Academic-Laboratory-Group/KL05_tester/README.md

# KL05_tester
Project for studies on subject Testing and Reliability.  
[Movie on YouTube](https://youtu.be/P3iQw-8CX4w)
