Academic-Laboratory-Group/KL05_tester/KiCadFiles/TestBed_KL05_variant_01_f.kicad_pcb

## KiCad design KiCadFiles/TestBed_KL05_variant_01_f.kicad_pcb (2021-08-31)

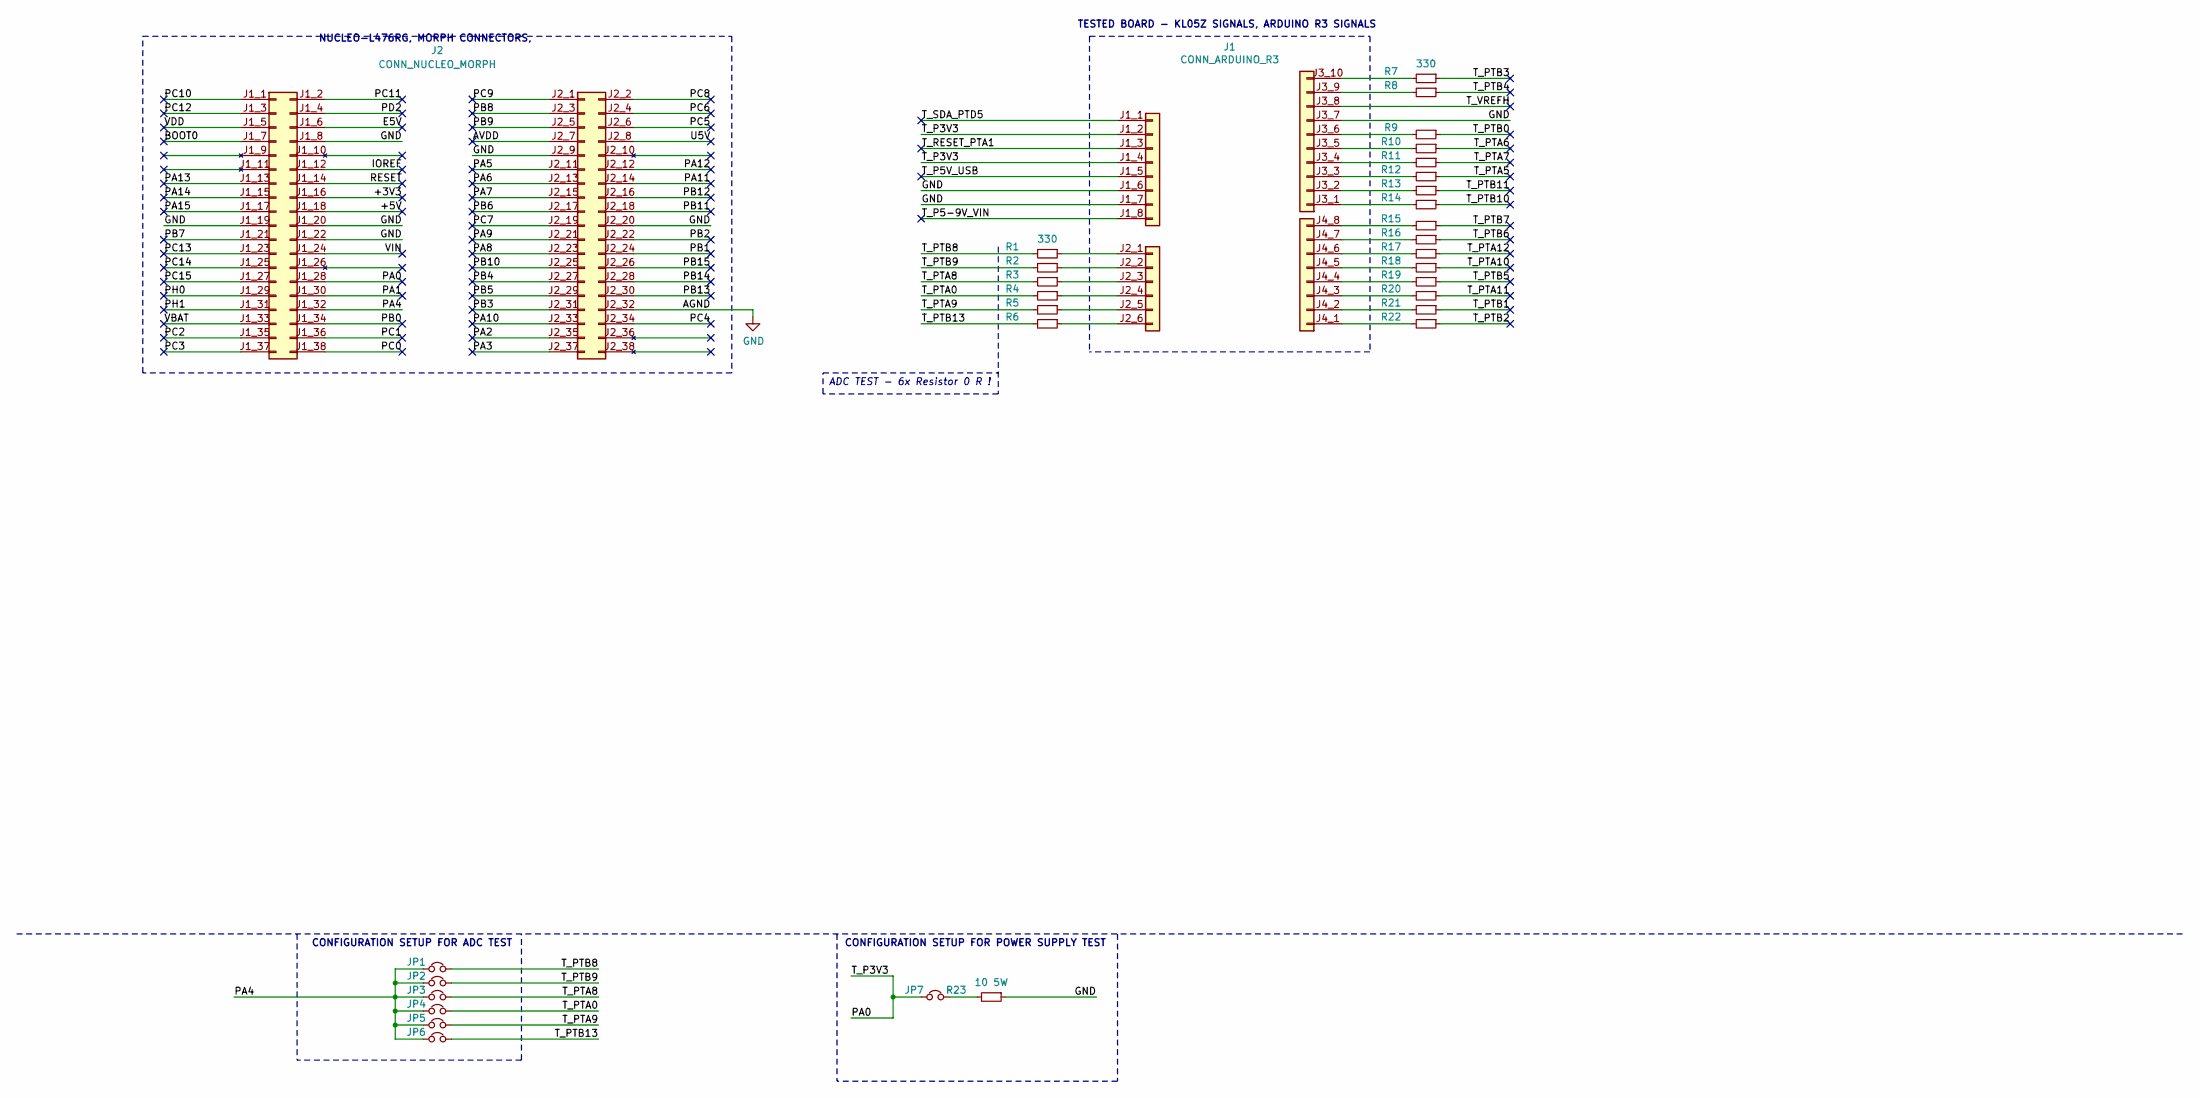
[picture p48: schematic TestBed_KL05_variant_01_f.sch]

Parts:
J1: CONN_ARDUINO_R3
J2: CONN_NUCLEO_MORPH; CONN_MORPH_NUCLEO
JP1, JP2, JP3, JP4, JP5, JP6, JP7: Jumper; PinHeader_1x02_P2.54mm_Vertical
R1, R2, R3, R4, R5, R6, R7, R8, R9, R10, R11, R12, R13, R14, R15, R16, R17, R18, R19, R20, R21, R22: 330; R_0805_2012Metric_Pad1.15x1.40mm_HandSolder
R23: 10 5W; R_Axial_DIN0411_L9.9mm_D3.6mm_P12.70mm_Horizontal

Connections:
/+3V3: J2.J1_16
/+5V: J2.J1_18
/AVDD: J2.J2_7
/BOOT0: J2.J1_7
/E5V: J2.J1_6
/IOREF: J2.J1_12
/PA0: J1.J1_2, J1.J1_4, J2.J1_28, JP7.2
/PA1: J2.J1_30
/PA2: J2.J2_35
/PA3: J2.J2_37
/PA4: J2.J1_32, JP1.2, JP2.2, JP3.2, JP4.2, JP5.2, JP6.2
/PA5: J2.J2_11
/PA6: J2.J2_13
/PA7: J2.J2_15
/PA8: J2.J2_23
/PA9: J2.J2_21
/PA10: J2.J2_33
/PA11: J2.J2_14
/PA12: J2.J2_12
/PA13: J2.J1_13
/PA14: J2.J1_15
/PA15: J2.J1_17
/PB0: J2.J1_34
/PB1: J2.J2_24
/PB2: J2.J2_22
/PB3: J2.J2_31
/PB4: J2.J2_27
/PB5: J2.J2_29
/PB6: J2.J2_17
/PB7: J2.J1_21
/PB8: J2.J2_3
/PB9: J2.J2_5
/PB10: J2.J2_25
/PB11: J2.J2_18
/PB12: J2.J2_16
/PB13: J2.J2_30
/PB14: J2.J2_28
/PB15: J2.J2_26
/PC0: J2.J1_38
/PC1: J2.J1_36
/PC2: J2.J1_35
/PC3: J2.J1_37
/PC4: J2.J2_34
/PC5: J2.J2_6
/PC6: J2.J2_4
/PC7: J2.J2_19
/PC8: J2.J2_2
/PC9: J2.J2_1
/PC10: J2.J1_1
/PC11: J2.J1_2
/PC12: J2.J1_3
/PC13: J2.J1_23
/PC14: J2.J1_25
/PC15: J2.J1_27
/PD2: J2.J1_4
/PH0: J2.J1_29
/PH1: J2.J1_31
/RESET: J2.J1_14
/T_P5-9V_VIN: J1.J1_8
/T_P5V_USB: J1.J1_5
/T_PTA0: JP4.1, R4.2
/T_PTA5: R12.1
/T_PTA6: R10.1
/T_PTA7: R11.1
/T_PTA8: JP3.1, R3.2
/T_PTA9: JP5.1, R5.2
/T_PTA10: R18.1
/T_PTA11: R20.1
/T_PTA12: R17.1
/T_PTB0: R9.1
/T_PTB1: R21.1
/T_PTB2: R22.1
/T_PTB3: R7.1
/T_PTB4: R8.1
/T_PTB5: R19.1
/T_PTB6: R16.1
/T_PTB7: R15.1
/T_PTB8: JP1.1, R1.2
/T_PTB9: JP2.1, R2.2
/T_PTB10: R14.1
/T_PTB11: R13.1
/T_PTB13: JP6.1, R6.2
/T_RESET_PTA1: J1.J1_3
/T_SDA_PTD5: J1.J1_1
/T_VREFH: J1.J3_8
/U5V: J2.J2_8
/VBAT: J2.J1_33
/VDD: J2.J1_5
/VIN: J2.J1_24
GND: J1.J1_6, J1.J1_7, J1.J3_7, J2.J1_8, J2.J1_19, J2.J1_20, J2.J1_22, J2.J2_9, J2.J2_20, J2.J2_32, R23.1
unnamed: J1.J2_1, R1.1
unnamed: J1.J2_2, R2.1
unnamed: J1.J2_3, R3.1
unnamed: J1.J2_4, R4.1
unnamed: J1.J2_5, R5.1
unnamed: J1.J2_6, R6.1
unnamed: J1.J3_1, R14.2
unnamed: J1.J3_2, R13.2
unnamed: J1.J3_3, R12.2
unnamed: J1.J3_4, R11.2
unnamed: J1.J3_5, R10.2
unnamed: J1.J3_6, R9.2
unnamed: J1.J3_9, R8.2
unnamed: J1.J3_10, R7.2
unnamed: J1.J4_1, R22.2
unnamed: J1.J4_2, R21.2
unnamed: J1.J4_3, R20.2
unnamed: J1.J4_4, R19.2
unnamed: J1.J4_5, R18.2
unnamed: J1.J4_6, R17.2
unnamed: J1.J4_7, R16.2
unnamed: J1.J4_8, R15.2
unnamed: JP7.1, R23.2

Notes on the sheet:
CONFIGURATION SETUP FOR ADC TEST
NUCLEO-L476RG, MORPH CONNECTORS,
ADC TEST - 6x Resistor 0 R !
TESTED BOARD - KL05Z SIGNALS, ARDUINO R3 SIGNALS
CONFIGURATION SETUP FOR POWER SUPPLY TEST

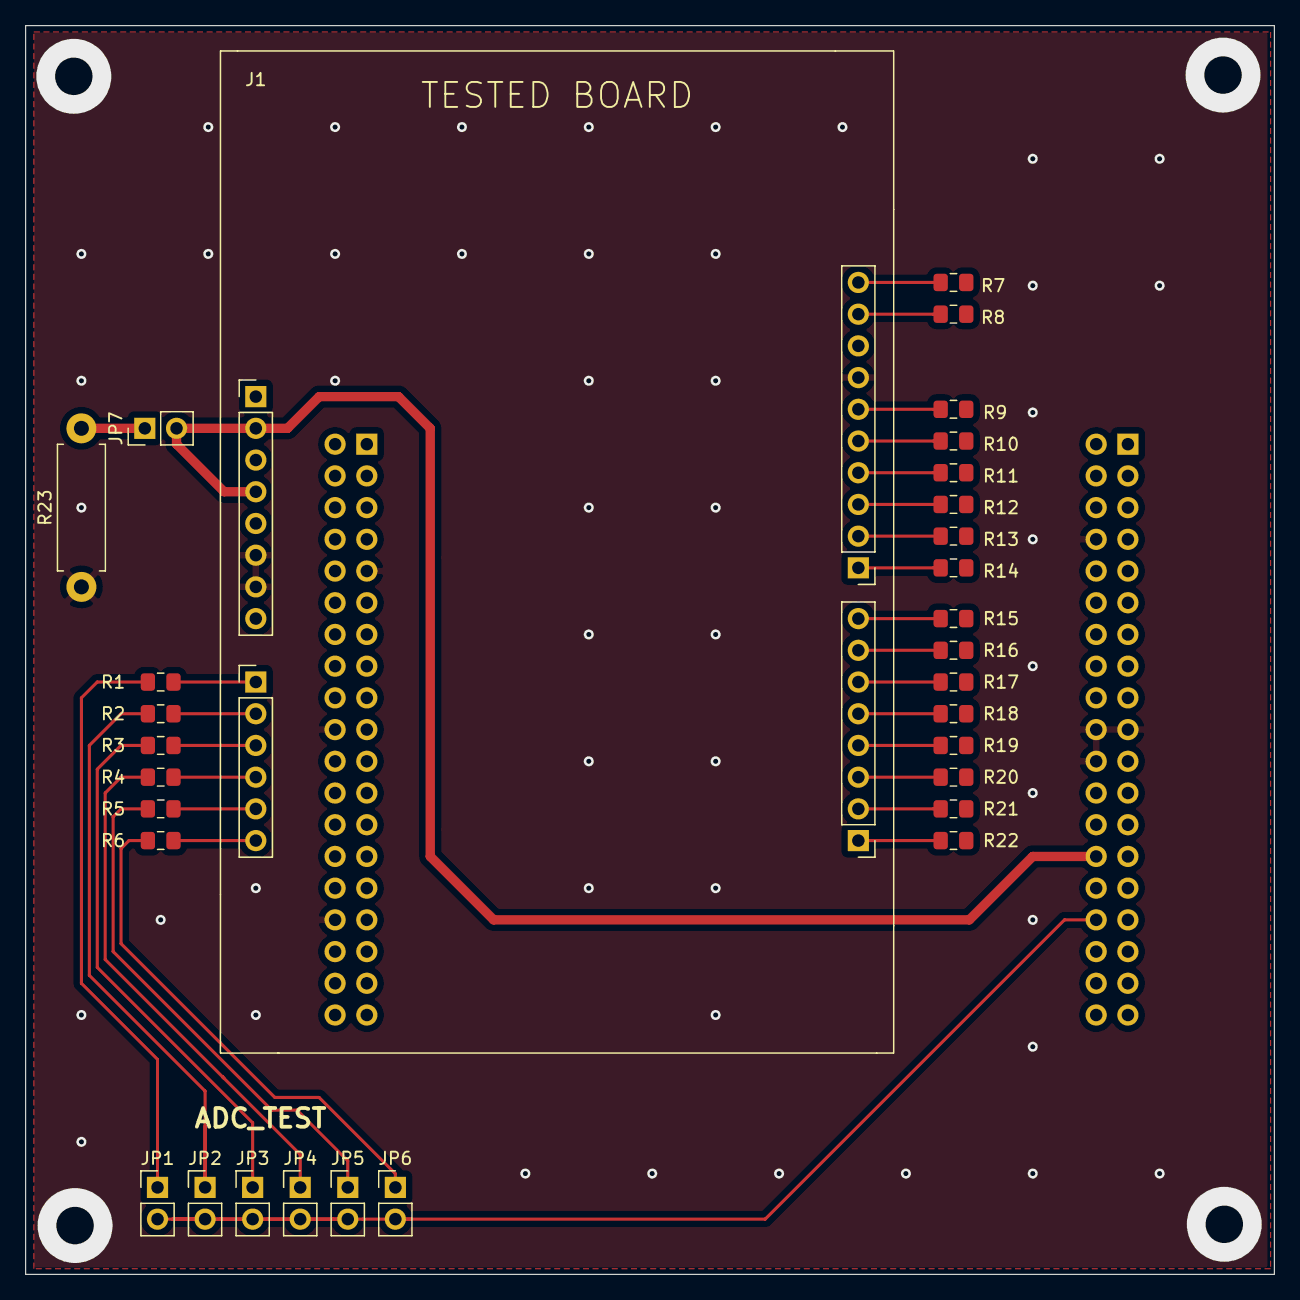
[picture p49: board TestBed_KL05_variant_01_f.kicad_pcb from above]

Board: 2 copper layers, 100.0 x 100.0 mm, 32 parts (1 on the bottom side), 32 nets.
