Academic-Laboratory-Group/KL05_tester/NucleoProjectFiles/ADC/Core/Src/main.c

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
/* Includes ------------------------------------------------------------------*/
#include "main.h"


DAC_HandleTypeDef hdac;

UART_HandleTypeDef huart3;
DMA_HandleTypeDef hdma_usart3_rx;

void SystemClock_Config(void);
static void MX_GPIO_Init(void);
static void MX_DMA_Init(void);
static void MX_USART3_UART_Init(void);
static void MX_DAC_Init(void);
/* USER CODE BEGIN 0 */
void prepare_myTxDataUart3(int value);

uint8_t myTxDataUart3[11] = "";
uint8_t myRxDataUart3[11];

int valueToSet = 0;

uint8_t setValue = 0;

/* USER CODE END 0 */

/**
  * @brief  The application entry point.
  * @retval int
  */
int main(void)
{
  /* MCU Configuration--------------------------------------------------------*/

  /* Reset of all peripherals, Initializes the Flash interface and the Systick. */
  HAL_Init();

  /* Configure the system clock */
  SystemClock_Config();

  /* Initialize all configured peripherals */
  MX_GPIO_Init();
  MX_DMA_Init();
  MX_USART3_UART_Init();
  MX_DAC_Init();
  /* USER CODE BEGIN 2 */
  HAL_UART_Receive_DMA(&huart3, myRxDataUart3, 5);

  HAL_DAC_SetValue(&hdac, DAC_CHANNEL_1, DAC_ALIGN_12B_R, 0);
  HAL_DAC_Start(&hdac , DAC_CHANNEL_1) ;
  /* USER CODE END 2 */

  /* Infinite loop */
  /* USER CODE BEGIN WHILE */
  while (1)
  {
    /* USER CODE END WHILE */

    /* USER CODE BEGIN 3 */

	  if (setValue == 1)
	  {
		  HAL_DAC_SetValue(&hdac, DAC_CHANNEL_1, DAC_ALIGN_12B_R, valueToSet);

		  HAL_Delay(1);

		  prepare_myTxDataUart3(valueToSet);
		  HAL_UART_Transmit(&huart3, myTxDataUart3, 6, 10);
		  setValue = 0;
	  }
  }
  /* USER CODE END 3 */
}

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
/* USER CODE BEGIN 4 */
void HAL_UART_RxCpltCallback(UART_HandleTypeDef *huart)
{
  /* Prevent unused argument(s) compilation warning */
  UNUSED(huart);

  /* NOTE : This function should not be modified, when the callback is needed,
            the HAL_UART_RxCpltCallback can be implemented in the user file.
   */
  valueToSet = ((int)myRxDataUart3[0] - 48) * 1000;
  valueToSet += ((int)myRxDataUart3[1] - 48) * 100;
  valueToSet += ((int)myRxDataUart3[2] - 48) * 10;
  valueToSet += ((int)myRxDataUart3[3] - 48);

  setValue = 1;
}

void prepare_myTxDataUart3(int value){
	int num = 1000;
	for (int i = 0; i < 4 ; i++)
	{
		myTxDataUart3[i] = (char)((value / num ) % 10 + 48);
		num /= 10;
	}
	myTxDataUart3[4] = '\r';
	myTxDataUart3[5] = '\n';
}

/* USER CODE END 4 */
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
