Academic-Laboratory-Group/KL05_tester/NucleoProjectFiles/SupplyTest/SupplyTest.ioc

PH0-OSC_IN.Signal=RCC_OSC_IN
Mcu.UserName=STM32F446RETx
PA14.GPIO_Label=TCK
PC13.GPIO_Label=B1 [Blue PushButton]
PA2.GPIO_Label=USART_TX
PA3.Signal=USART2_RX
PB3.GPIO_Label=SWO
PC13.Signal=GPXTI13
PC14-OSC32_IN.Signal=RCC_OSC32_IN
PA0-WKUP.Signal=ADCx_IN0
PA13.Signal=SYS_JTMS-SWDIO
PC15-OSC32_OUT.Signal=RCC_OSC32_OUT
PA1.Signal=ADCx_IN1
PA5.Signal=GPIO_Output
PH1-OSC_OUT.Signal=RCC_OSC_OUT
PA2.Signal=USART2_TX
PA13.GPIO_Label=TMS
PB3.Signal=SYS_JTDO-SWO
PA5.GPIO_Label=LD2 [Green Led]
PA14.Signal=SYS_JTCK-SWCLK
PA3.GPIO_Label=USART_RX
