Academic-Laboratory-Group/KL05_tester/NucleoProjectFiles/SupplyTest/Core/Src/main.c

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
/* Includes ------------------------------------------------------------------*/
#include "main.h"
#include <stdlib.h>
#include <stdio.h>
ADC_HandleTypeDef hadc1;
DMA_HandleTypeDef hdma_adc1;

TIM_HandleTypeDef htim14;

UART_HandleTypeDef huart2;
DMA_HandleTypeDef hdma_usart2_rx;
DMA_HandleTypeDef hdma_usart2_tx;

void SystemClock_Config(void);
static void MX_GPIO_Init(void);
static void MX_DMA_Init(void);
static void MX_USART2_UART_Init(void);
static void MX_ADC1_Init(void);
static void MX_TIM14_Init(void);
/* USER CODE BEGIN 0 */
uint8_t Received[7];

uint8_t counterMeasurement = 0;
uint8_t amountMeasurement = 30;
uint16_t PomiarADC[2];

const float SupplyVoltage = 3.3; // [Volts]
const float ADCResolution = 4096.0;

uint8_t WhichTest(void);

enum
{
	NoneTest = 0,
	Test3V3 = 1,
	Test5V = 2,
};


/////////////
const float Resistance = 10.0;//ohm
const float PeriodMeasurement = 0.5;
///////////
/* USER CODE END 0 */

/**
  * @brief  The application entry point.
  * @retval int
  */
int main(void)
{
  /* MCU Configuration--------------------------------------------------------*/

  /* Reset of all peripherals, Initializes the Flash interface and the Systick. */
  HAL_Init();

  /* Configure the system clock */
  SystemClock_Config();

  /* Initialize all configured peripherals */
  MX_GPIO_Init();
  MX_DMA_Init();
  MX_USART2_UART_Init();
  MX_ADC1_Init();
  MX_TIM14_Init();
  /* USER CODE BEGIN 2 */
  HAL_UART_Receive_DMA(&huart2, Received, 3);
  HAL_ADC_Start_DMA(&hadc1, PomiarADC, 2);
  /* USER CODE END 2 */

  /* Infinite loop */
  /* USER CODE BEGIN WHILE */
  while (1)
  {
    /* USER CODE END WHILE */

    /* USER CODE BEGIN 3 */
  }
  /* USER CODE END 3 */
}

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
/* USER CODE BEGIN 4 */
void HAL_UART_RxCpltCallback(UART_HandleTypeDef *huart)
{
	UNUSED(huart);
	if(WhichTest() == Test3V3 || WhichTest() == Test5V)
	{
		HAL_TIM_Base_Start_IT(&htim14);
		HAL_GPIO_TogglePin(GPIOA, GPIO_PIN_5);
	}
	HAL_UART_Receive_DMA(&huart2, Received, 3); // Ponowne włączenie nasłuchiwania
}

void HAL_TIM_PeriodElapsedCallback(TIM_HandleTypeDef *htim)
{
	if(htim->Instance == TIM14)
	{
		float Voltage;
		float Current;
		float Time;

		counterMeasurement++;
		if (WhichTest() == Test3V3)
			Voltage = (SupplyVoltage*PomiarADC[0])/(ADCResolution-1); // Przeliczenie wartosci zmierzonej na napiecie
		else if (WhichTest() == Test5V)
			Voltage = (SupplyVoltage*PomiarADC[1])/(ADCResolution-1);
		else if (WhichTest() == NoneTest)
		{
			counterMeasurement = 0;
			HAL_TIM_Base_Stop_IT(&htim14);
		}

		Current = Voltage/Resistance;
		Time = PeriodMeasurement*counterMeasurement;

		int sizeVoltage = snprintf(0, 0, "%.2f", Voltage); // convertion float to string
		int sizeCurrent = snprintf(0, 0, "%.2f", Current);
		int sizeTime = snprintf(0, 0, "%.2f", Time);

		int size = sizeVoltage + sizeCurrent + sizeTime + 6;
		char buffer[size];

		snprintf(buffer, size,"%.2f;%.2f;%.2f", Voltage,Current,Time);

		uint8_t Transmit[size + 1];
		sprintf(Transmit, "%s\r\n", buffer);

		HAL_UART_Transmit_DMA(&huart2, Transmit , size + 1);

		if (counterMeasurement == amountMeasurement)
		{
			counterMeasurement = 0;
			HAL_TIM_Base_Stop_IT(&htim14);
		}

	}
}

uint8_t WhichTest(void)
{
	if (Received[0] == '3' && Received[1] == 'V' && Received[2] == '3')
		return Test3V3;
	else if (Received[0] == '+' && Received[1] == '5' && Received[2] == 'V')
		return Test5V;
	else
		return NoneTest;
}

/* USER CODE END 4 */
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
