Academic-Laboratory-Group/KL05_tester/(commit log)

2021-07-25 cleaning up & refresh button & warnings rather than critical error 69
    [TestBed_KL05_variant_01_f.sch, TestBed_KL05_variant_02_f.sch, TestBed_KL05_variant_1_f.kicad_pcb, TestBed_KL05_variant_2_f.kicad_pcb]
2021-07-25 Problems with connection handled v.1 & and some studpid coder's double language translations fix
    [main.py]
2021-07-26 Add first projekt for Power Supply
2021-08-28 More catching errors, Ready for programing STM
    [main.py]
2021-08-29 uart communication
2021-08-29 uart string receive
2021-08-30 Update PCB
    [TestBed_KL05_variant_01_f.kicad_pcb, TestBed_KL05_variant_01_f.sch, TestBed_KL05_variant_02_f.kicad_pcb, TestBed_KL05_variant_02_f.sch]
2021-08-31 Update documentation
    [TestBed_KL05_variant_02_f.kicad_pcb]
2021-09-02 Add documentation for POWER SUPPY TEST
